freakone/Skoczek/eagle/plytka.brd

## EAGLE design eagle/plytka.brd (2014-01-03)

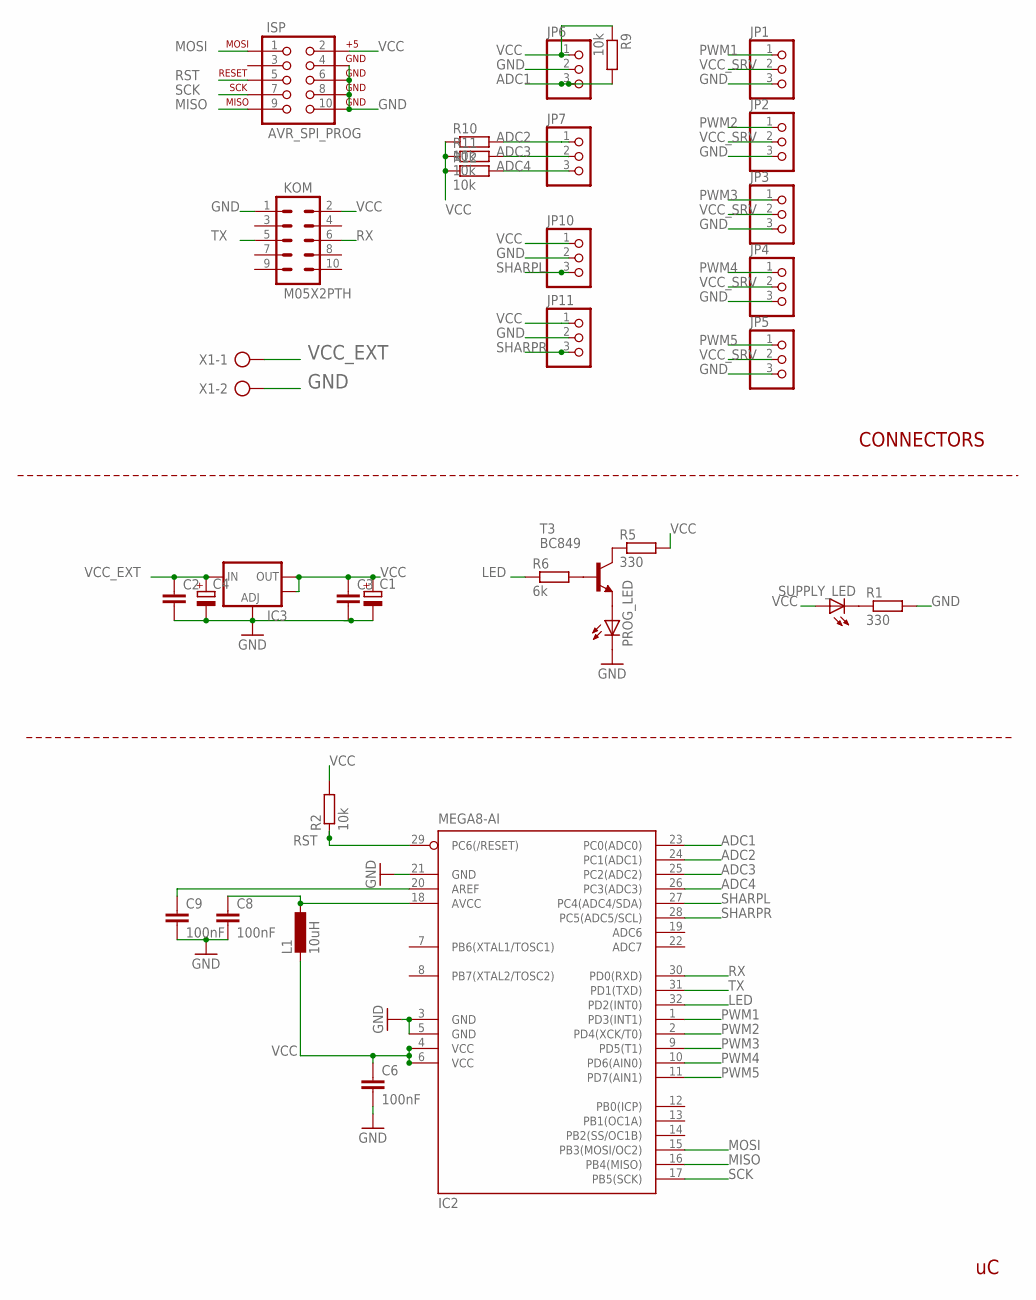
[picture p2: schematic plytka.sch]

Parts:
C1, C4: CPOL-EUE5-10.5; E5-10,5
C2, C3: C-EUC0805; C0805
C6, C8, C9: 100nF; C0805
IC2: MEGA8-AI; TQFP32-08
IC3: V_REG_LM1117SOT223; SOT223
ISP: AVR_SPI_PROG; AVR_ICSP
JP1, JP2, JP3, JP4, JP5, JP6, JP7, JP10, JP11: PINHD-1X3; 1X03
KOM: M05X2PTH; AVR_ICSP
L1: 10uH; L2012C
PROG_LED: LEDCHIPLED_0805; CHIPLED_0805
R1, R5: 330; R0805
R2, R9, R10, R11, R12: 10k; M0805
R6: 6k; R0805
SUPPLY_LED: LEDCHIPLED_0805; CHIPLED_0805
T3: BC849; SOT23
X1: AK300/2

Connections:
ADC1: IC2.23 (PC0(ADC0)), JP6.3, R9.2
ADC2: IC2.24 (PC1(ADC1)), JP7.1, R10.2
ADC3: IC2.25 (PC2(ADC2)), JP7.2, R11.2
ADC4: IC2.26 (PC3(ADC3)), JP7.3, R12.2
GND: C1.-, C2.2, C3.2, C4.-, C6.2, C8.2, C9.2, IC2.3 (GND), IC2.5 (GND), IC2.21 (GND), IC3.1 (ADJ), ISP.4, ISP.6, ISP.8, ISP.10, JP1.3, JP2.3, JP3.3, JP4.3, JP5.3, JP6.2, JP10.2, JP11.2, KOM.1, PROG_LED.C, R1.2, X1.2
LED: IC2.32 (PD2(INT0)), R6.1
MISO: IC2.16 (PB4(MISO)), ISP.9
MOSI: IC2.15 (PB3(MOSI/OC2)), ISP.1
unnamed: R1.1, SUPPLY_LED.C
unnamed: C9.1, IC2.20 (AREF)
unnamed: PROG_LED.A, T3.2 (E)
unnamed: R6.2, T3.1 (B)
unnamed: R5.1, T3.3 (C)
unnamed: C8.1, IC2.18 (AVCC), L1.1
PWM1: IC2.1 (PD3(INT1)), JP1.1
PWM2: IC2.2 (PD4(XCK/T0)), JP2.1
PWM3: IC2.9 (PD5(T1)), JP3.1
PWM4: IC2.10 (PD6(AIN0)), JP4.1
PWM5: IC2.11 (PD7(AIN1)), JP5.1
RST: IC2.29 (PC6(/RESET)), ISP.5, R2.1
RX: IC2.30 (PD0(RXD)), KOM.6
SCK: IC2.17 (PB5(SCK)), ISP.7
SHARPL: IC2.27 (PC4(ADC4/SDA)), JP10.3
SHARPR: IC2.28 (PC5(ADC5/SCL)), JP11.3
TX: IC2.31 (PD1(TXD)), KOM.5
VCC: C1.+, C3.1, C6.1, IC2.4 (VCC), IC2.6 (VCC), IC3.2 (OUT), IC3.4 (OUT), ISP.2, JP6.1, JP10.1, JP11.1, KOM.2, L1.2, R2.2, R5.2, R9.1, R10.1, R11.1, R12.1, SUPPLY_LED.A
VCC_EXT: C2.1, C4.+, IC3.3 (IN), X1.1
VCC_SRV: JP1.2, JP2.2, JP3.2, JP4.2, JP5.2

Notes on the sheet:
CONNECTORS

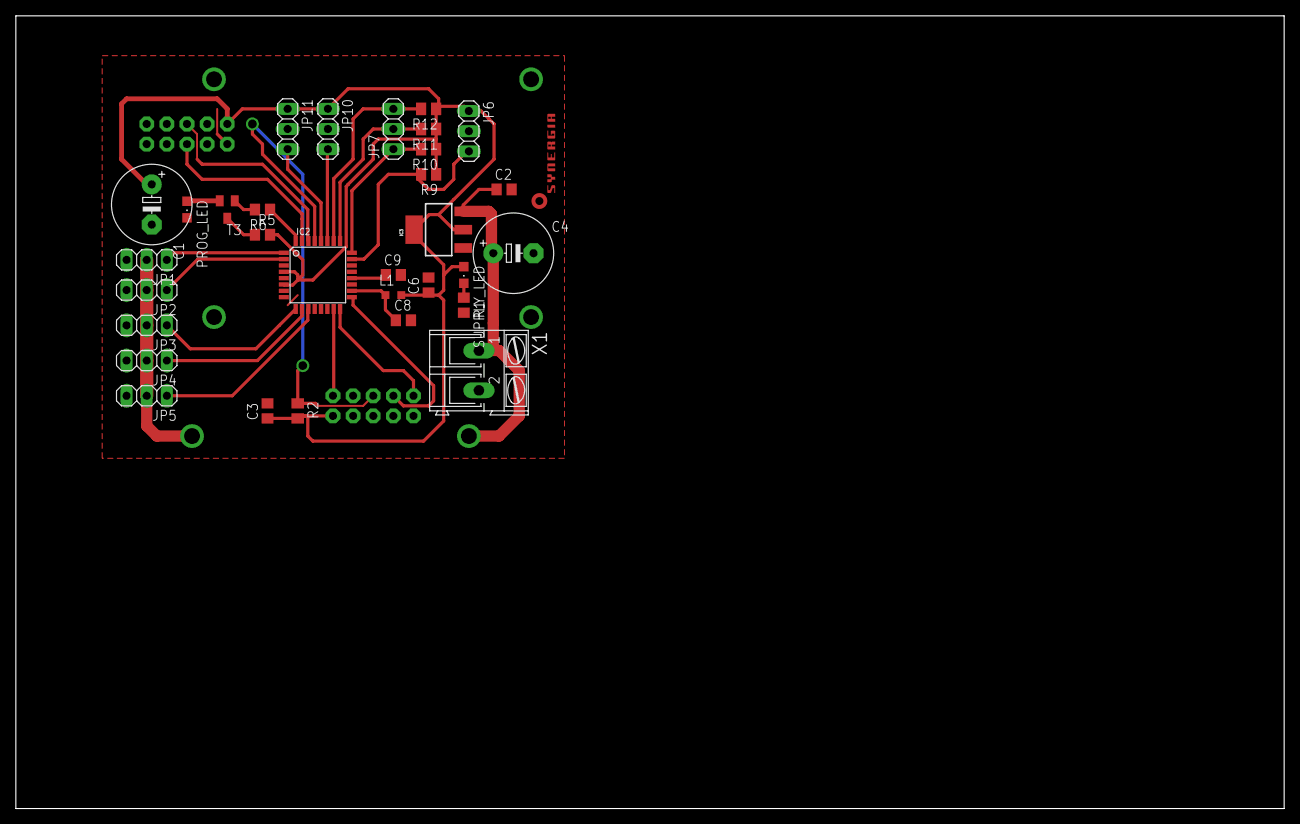
[picture p3: board plytka.brd from above]

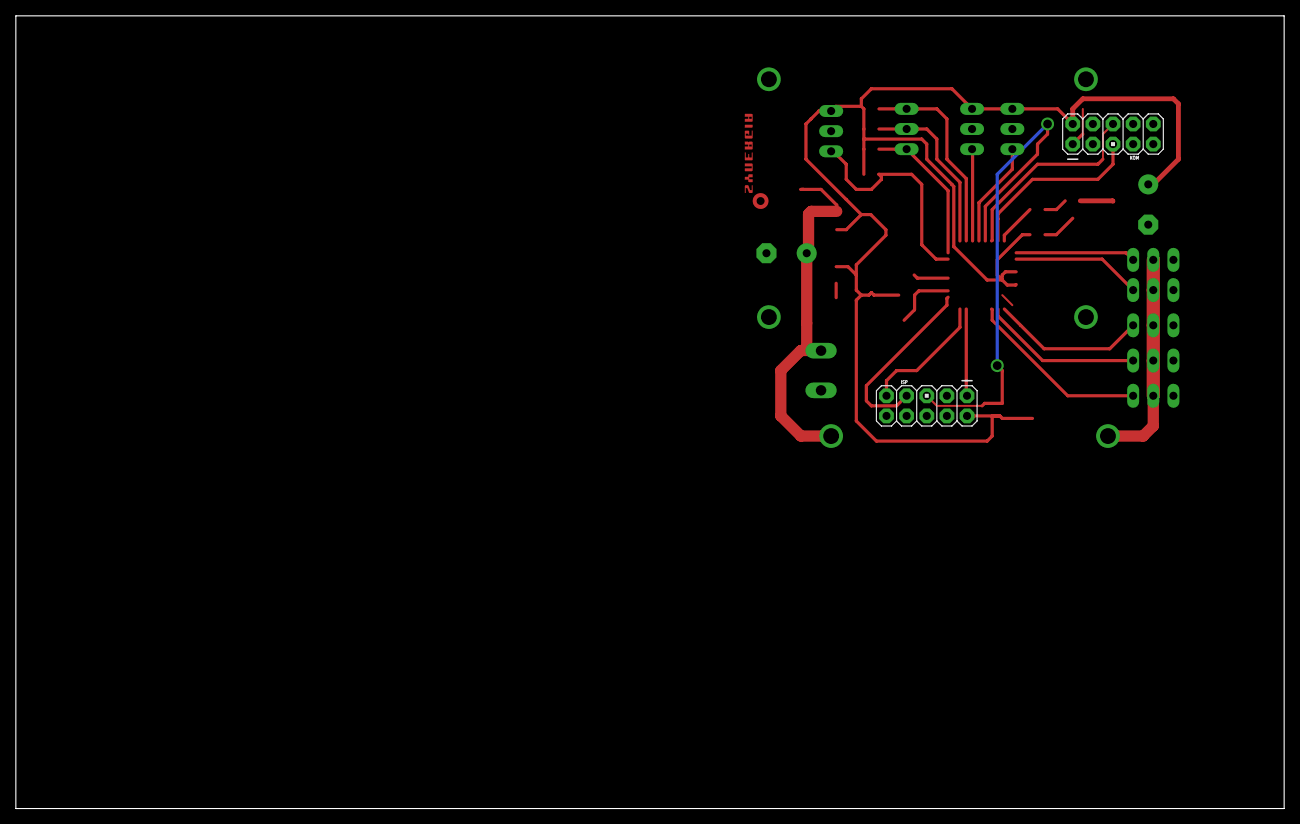
[picture p4: board plytka.brd from below]

Board: 2 copper layers, 160.0 x 100.0 mm, 34 parts (2 on the bottom side), 28 nets.

Other parts of the board:
U$1: SYNERGIA_12MM
