freakone/Skoczek/(commit log)

2014-01-02 corner case
2014-01-03 porządek
    [plytka.brd, plytka.sch]
